docvacuumtubes/3-500ZPowerSupply/BasicWallConnectorTry2.3mf

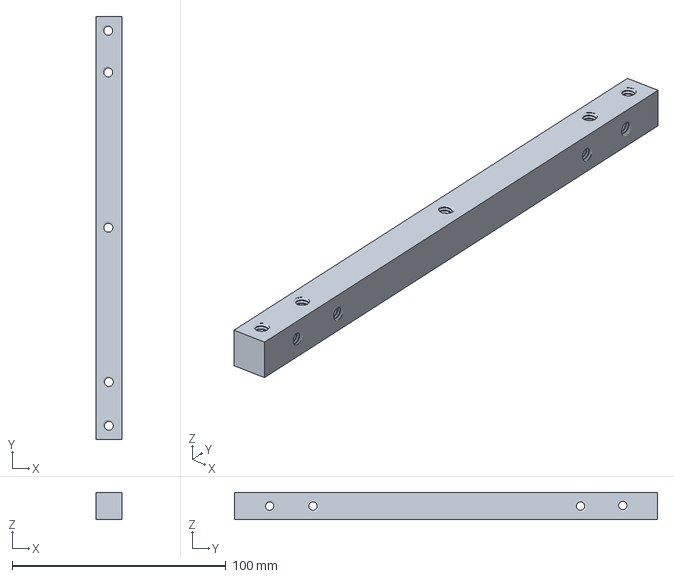
[picture p5: CAD file, 2026-10-17]
BasicWallConnectorTry2.3mf
12.0 x 198.0 x 12.7 mm
