docvacuumtubes/3-500ZPowerSupply/ShorterConnectingBar1.3mf

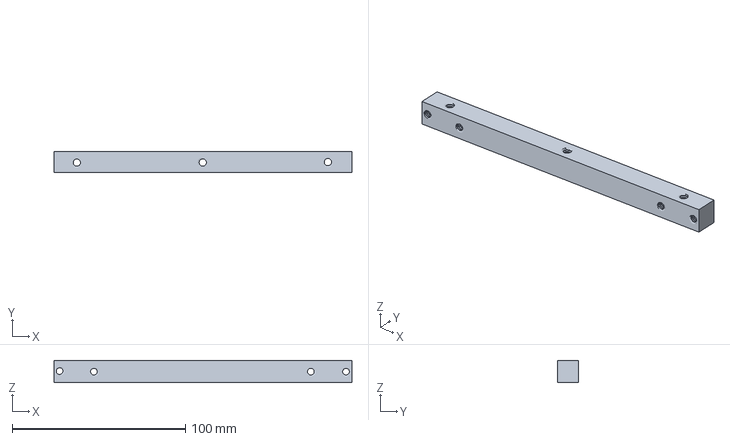
[picture p6: CAD file, 2026-10-17]
ShorterConnectingBar1.3mf
172.0 x 12.0 x 12.7 mm
