docvacuumtubes/3-500ZPowerSupply/HVResistorSet.3mf

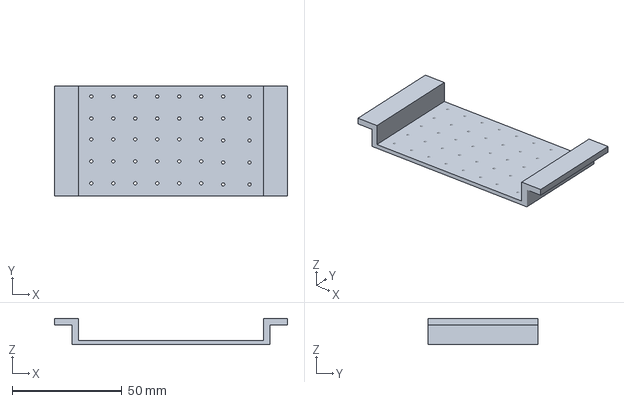
[picture p7: CAD file, 2026-10-17]
HVResistorSet.3mf
106.0 x 50.0 x 12.0 mm
