docvacuumtubes/3-500ZPowerSupply/FinalPowerSupplyBase (1).stl

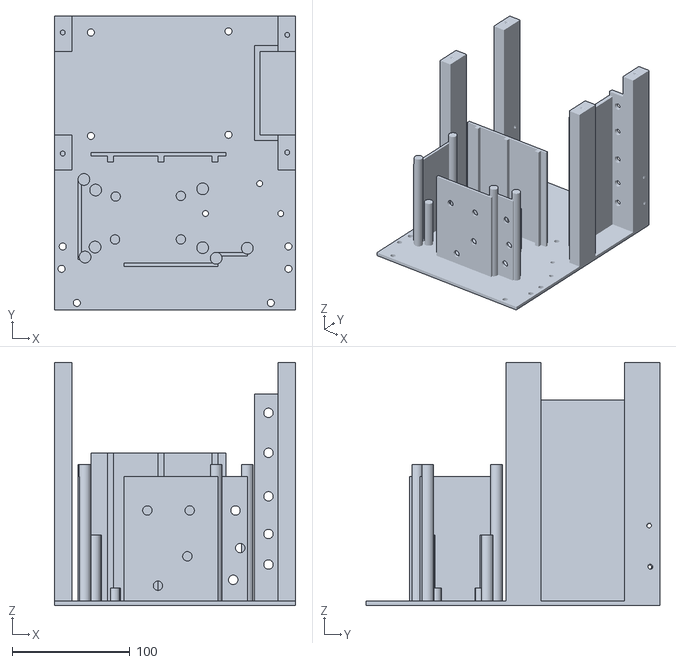
[picture p8: CAD file, 2026-10-17]
FinalPowerSupplyBase (1).stl
205.0 x 250.0 x 207.0
