docvacuumtubes/3-500ZPowerSupply/3-500Z Chimney Holder.stl

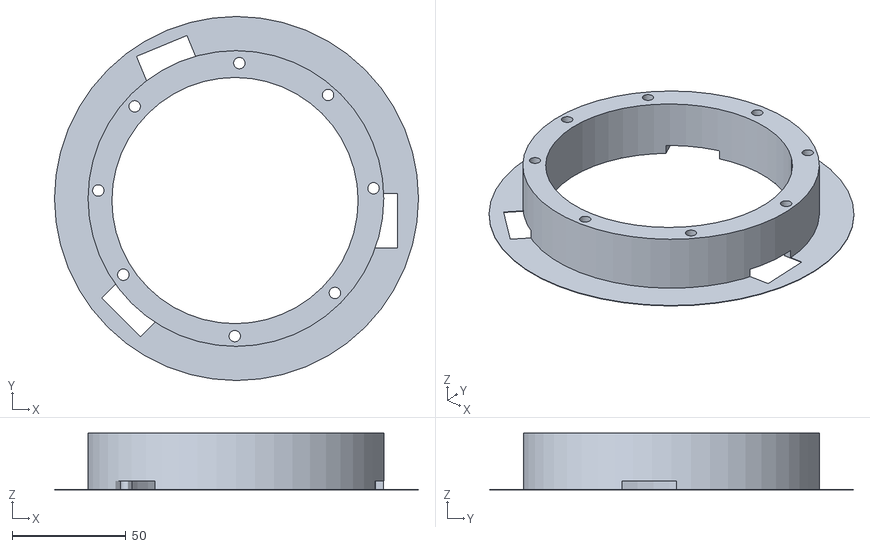
[picture p9: CAD file, 2026-10-17]
3-500Z Chimney Holder.stl
160.0 x 160.0 x 25.0
