docvacuumtubes/3-500ZPowerSupply/AboveTransformerPlate.stl

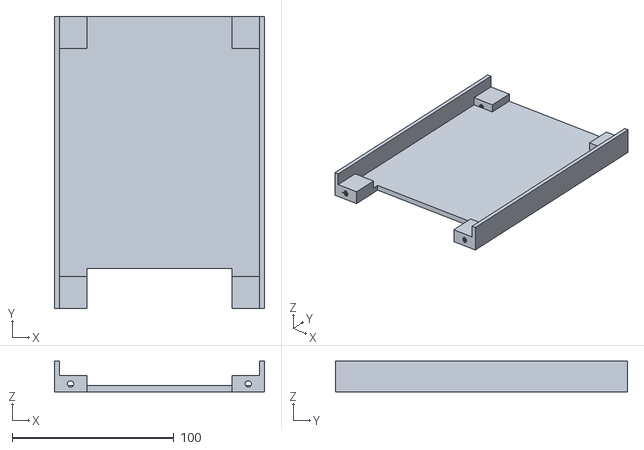
[picture p10: CAD file, 2026-10-17]
AboveTransformerPlate.stl
130.0 x 181.0 x 19.0
