docvacuumtubes/3-500ZPowerSupply/RelayOnTopWithResistorBank (1).stl

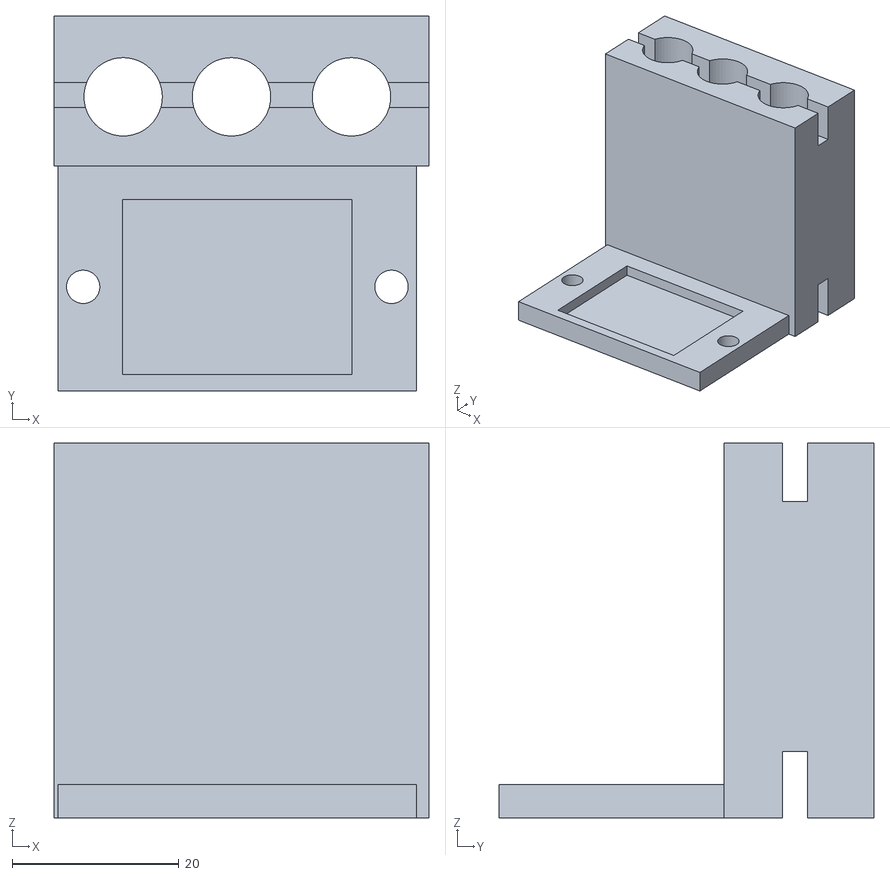
[picture p11: CAD file, 2026-10-17]
RelayOnTopWithResistorBank (1).stl
45.0 x 45.0 x 45.0
