docvacuumtubes/3-500ZPowerSupply/FrontPanelFromBehind1 (4).stl

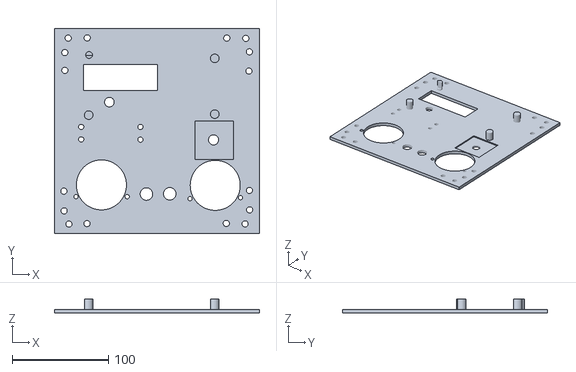
[picture p12: CAD file, 2026-10-17]
FrontPanelFromBehind1 (4).stl
213.0 x 213.0 x 15.0
