docvacuumtubes/3-500ZPowerSupply/(list of files, cad)

Other CAD files:
FinalPowerSupplyBase.3mf
HVResistorSet.stl
